H-unter/CC3501-Assignment-2/README.md

# CC3501 Assignment 2

design and build an embedded system to produce a useful product.
