H-unter/CC3501-Assignment-2/report/main.tex

\documentclass[11pt]{article} 
\def\names{Hunter Kruger-Ilingworth (14198489)\\ 
Quentin Bouet (14198423) \\
Thomas Mehes (14259613) \\}
\def\doctitle{Assignment 2 \\ Dew Point Generator Controller and Sensor Data Logger}
\def\subjectcode{CC3501}
\input{header.sty}

%Choose which files are re-rendered (saves rendering time)
%\includeonly{}

\newcommand{\insertimage}[3]{
\begin{figure}[h]
    \centering
     % Image filename
    \caption{#2} % Caption
    \label{#3} % Label
\end{figure}
}

\newcommand{\insertbigimage}[3]{
\begin{figure*}[h]
    \centering
     % Image filename
    \caption{#2} 
    \label{#3} 
\end{figure*}
}

\newcommand{\codeblock}[4]{
    \lstinputlisting[language=#1, caption={#2}, label=#3]{#4}
}

\newcommand{\E}[1]{
    \cdot 10^{#1}
}

\newcommand{\abs}[1]{
    \left\lvert #1 \right\rvert
}

\newcommand{\note}[1]{\textcolor{red}{#1}} %create a note for yourself

\definecolor{codegray}{gray}{0.9} % Light gray color
\newcommand{\code}[1]{\colorbox{codegray}{\texttt{\detokenize{#1}}}} % Command for inline code

\begin{document}
    % Create the title page
    \begin{titlepage}
        \maketitle
        \thispagestyle{empty} %suppresses page numbering on the title page
    \end{titlepage}

    % Table of Contents
    \thispagestyle{empty} % Suppresses page numbering on the contents page
    \onecolumn
    \tableofcontents
    \listoffigures
    \listoftables

    % Document - place new files as needed
    \clearpage
    \input{sec1_intro}
    \input{sec2_overview}
    \input{sec2.1_hardware_design}
    \input{sec2.2_comm_protocols}
    \input{sec2.3_user_interface}
    \input{sec3.1_challenges}
    \input{sec3.2_discussion}
    \input{sec3.3_recommendations}
    \input{sec4_conclusion}
    \input{sec5_appendix}

    \bibliographystyle{IEEEtranN} 
    \bibliography{references} 

\end{document}
