H-unter/CC3501-Assignment-2/report/figures/SDI-12 circuit.png

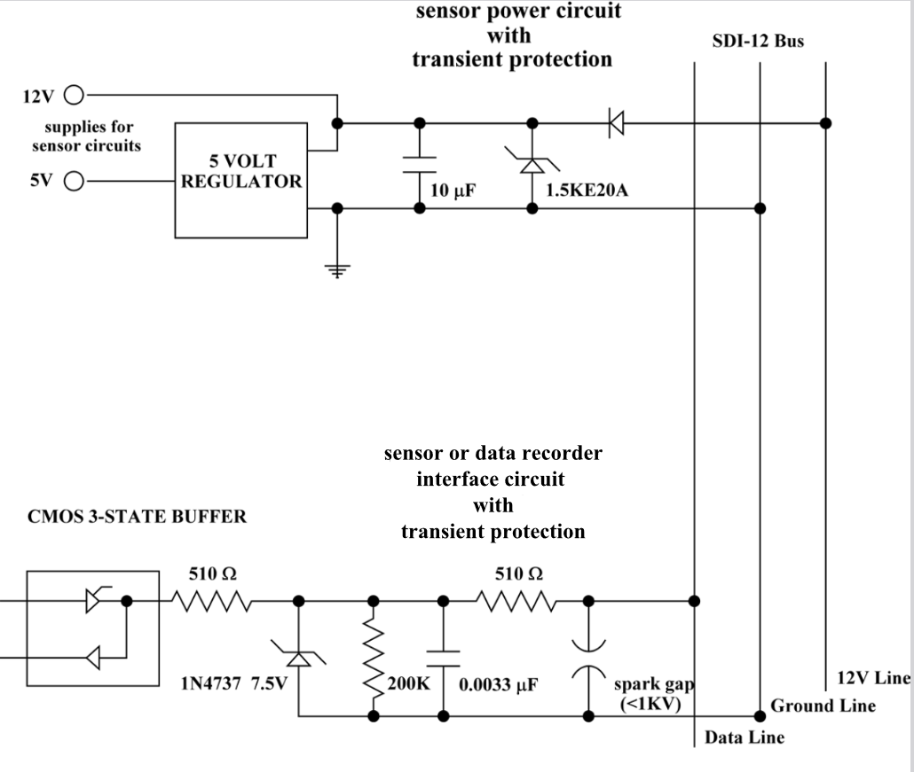
report/figures/SDI-12 circuit.png
