H-unter/CC3501-Assignment-2/report/figures/system_setup_2.jpg

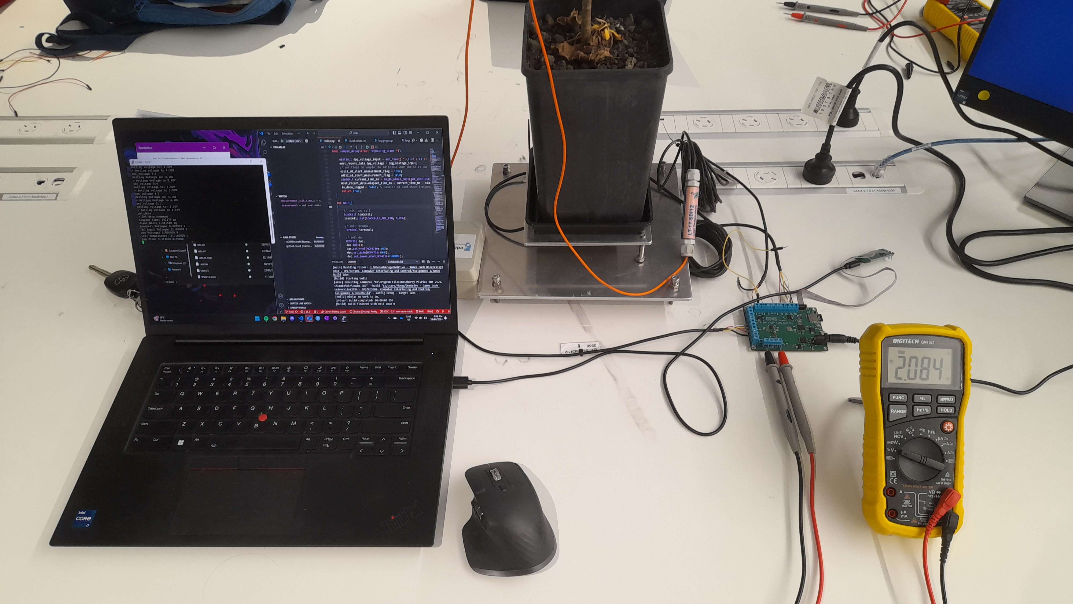
report/figures/system_setup_2.jpg
