H-unter/CC3501-Assignment-2/misc/loadcell_tuning_round2/mass_to_voltage.xlsx

mass_kg | voltage_v
0 | 0.131821
0.475 | 0.305
0.53 | 0.327356
0.885 | 0.447
1.565 | 0.679
2.28 | 0.9
2.81 | 1.047
3.895 | 1.286
4.3675 | 1.396
