H-unter/CC3501-Assignment-2/misc/loadcell_tuning_round1/loadcell_linearity_test.xlsx

input_kg | output_v | gain
0 | 0.76 | 75
0.2 | 0.76
0.4 | 0.76
0.6 | 0.76
1.8 | 0.76
2 | 0.824
2.2 | 0.89
2.4 | 0.962
2.6 | 0.994
2.8 | 1.02
3 | 1.05
3.2 | 1.09
3.4 | 1.14
3.6 | 1.18
3.8 | 1.22
4 | 1.24
4.2 | 1.29
4.4 | 1.33
4.6 | 1.37
4.8 | 1.39
5 | 1.44
