H-unter/CC3501-Assignment-2/misc/adc_smoothing_test/smoothed_readings_plot.pdf

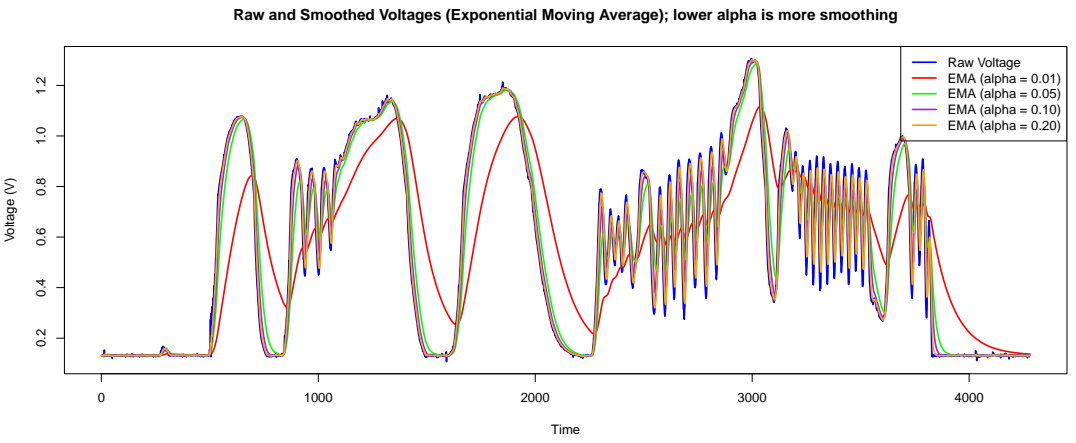
[picture p31: page 1]
Time; Voltage (V); Raw Voltage EMA (alpha = 0.01) EMA (alpha = 0.05) EMA (alpha = 0.10) EMA (alpha = 0.20)

Raw and Smoothed Voltages (Exponential Moving Average); lower alpha is more smoothing
