H-unter/CC3501-Assignment-2/misc/hardware_submission_files/Schematics.PDF

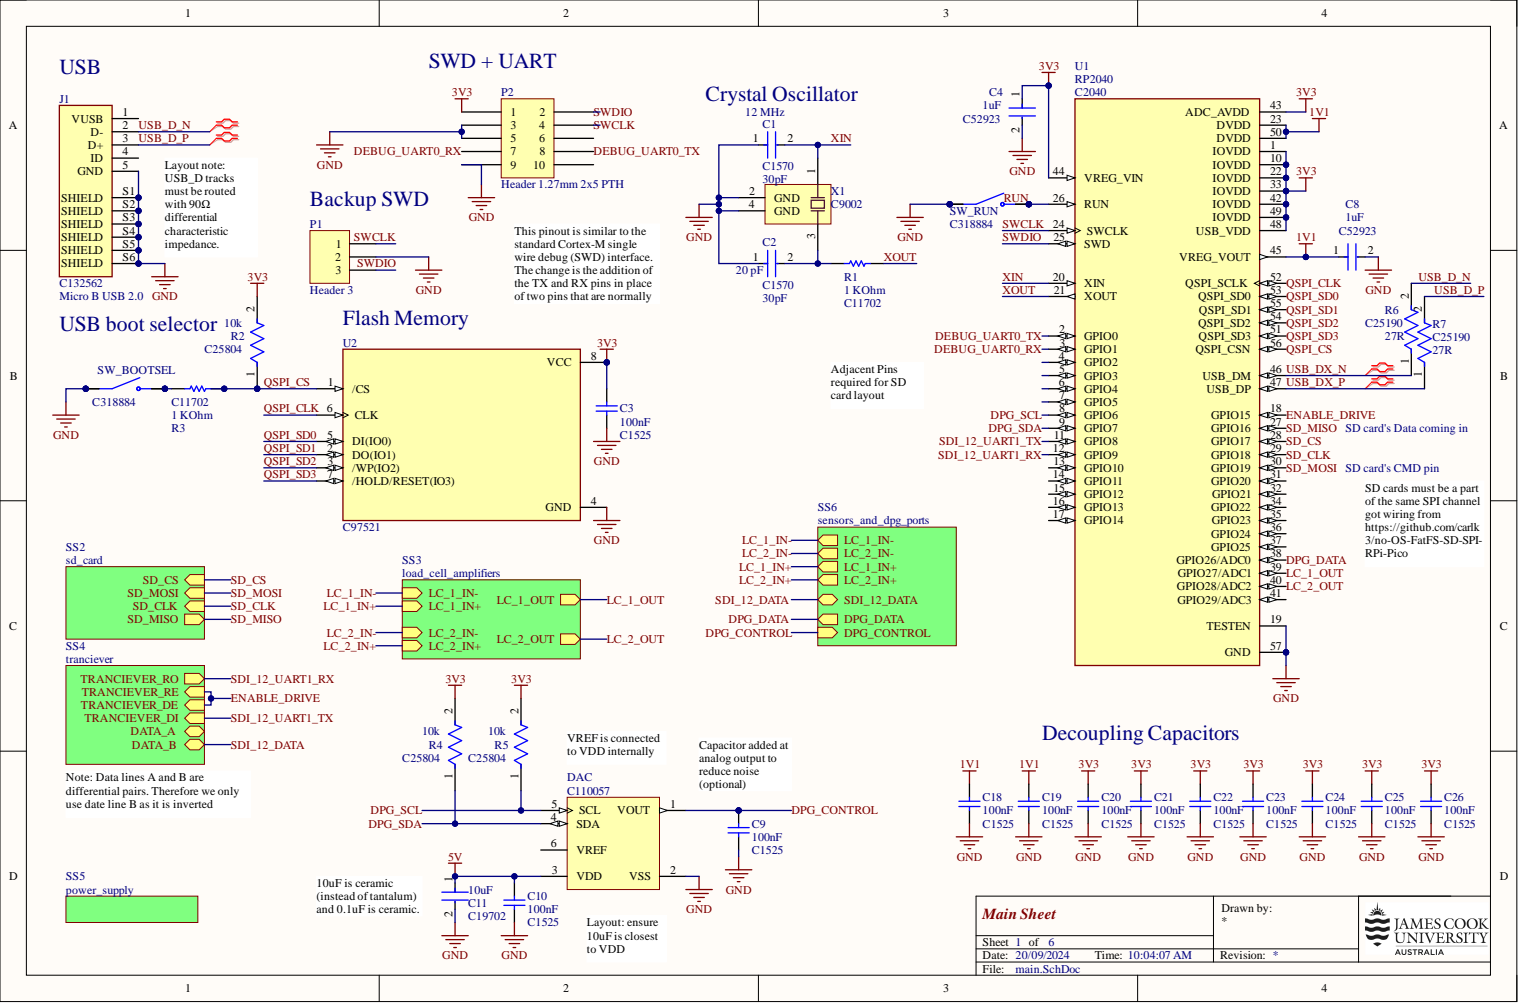
[picture p32: page 1]

This pinout is similar to the
standard Cortex-M single
wire debug (SWD) interface.
The change is the addition of
the TX and RX pins in place
of two pins that are normally

SD card's Data coming in

SD card's CMD pin
SD cards must be a part
of the same SPI channel
got wiring from
https://github.com/carlk
3/no-OS-FatFS-SD-SPI-
RPi-Pico

Note: Data lines A and B are
differential pairs. Therefore we only
use date line B as it is inverted

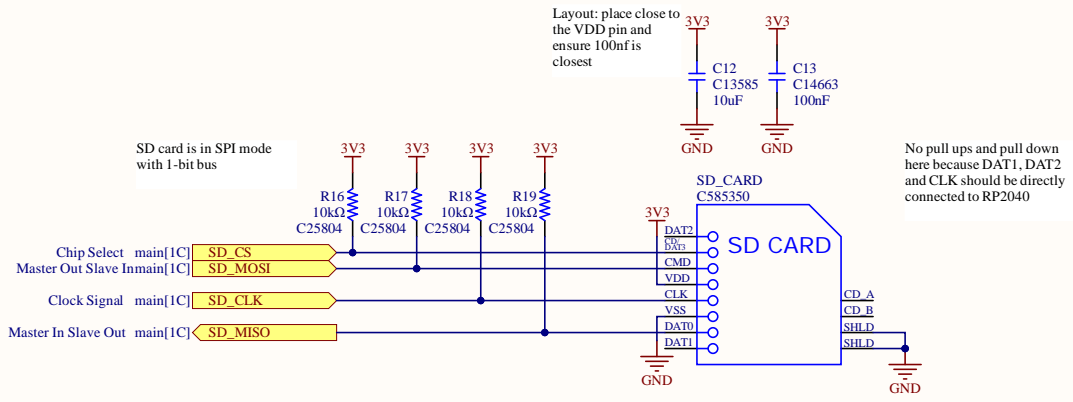
[picture p33: page 2]

Layout: place close to
the VDD pin and
ensure 100nf is
closest

SD card is in SPI mode
with 1-bit bus

No pull ups and pull down
here because DAT1, DAT2
and CLK should be directly
connected to RP2040

Chip Select
Master Out Slave In

Master In Slave Out

SD Card Reader Header

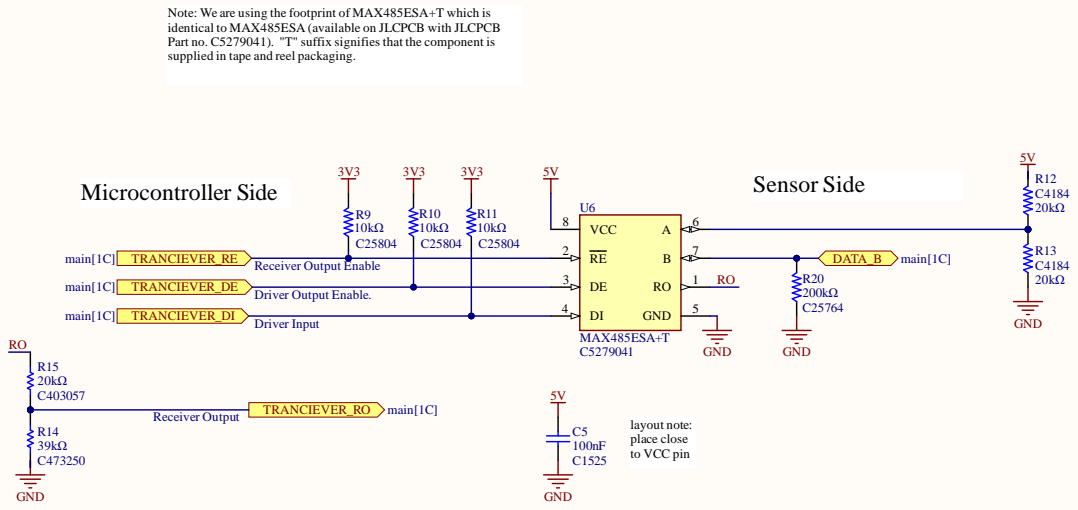
[picture p34: page 3]

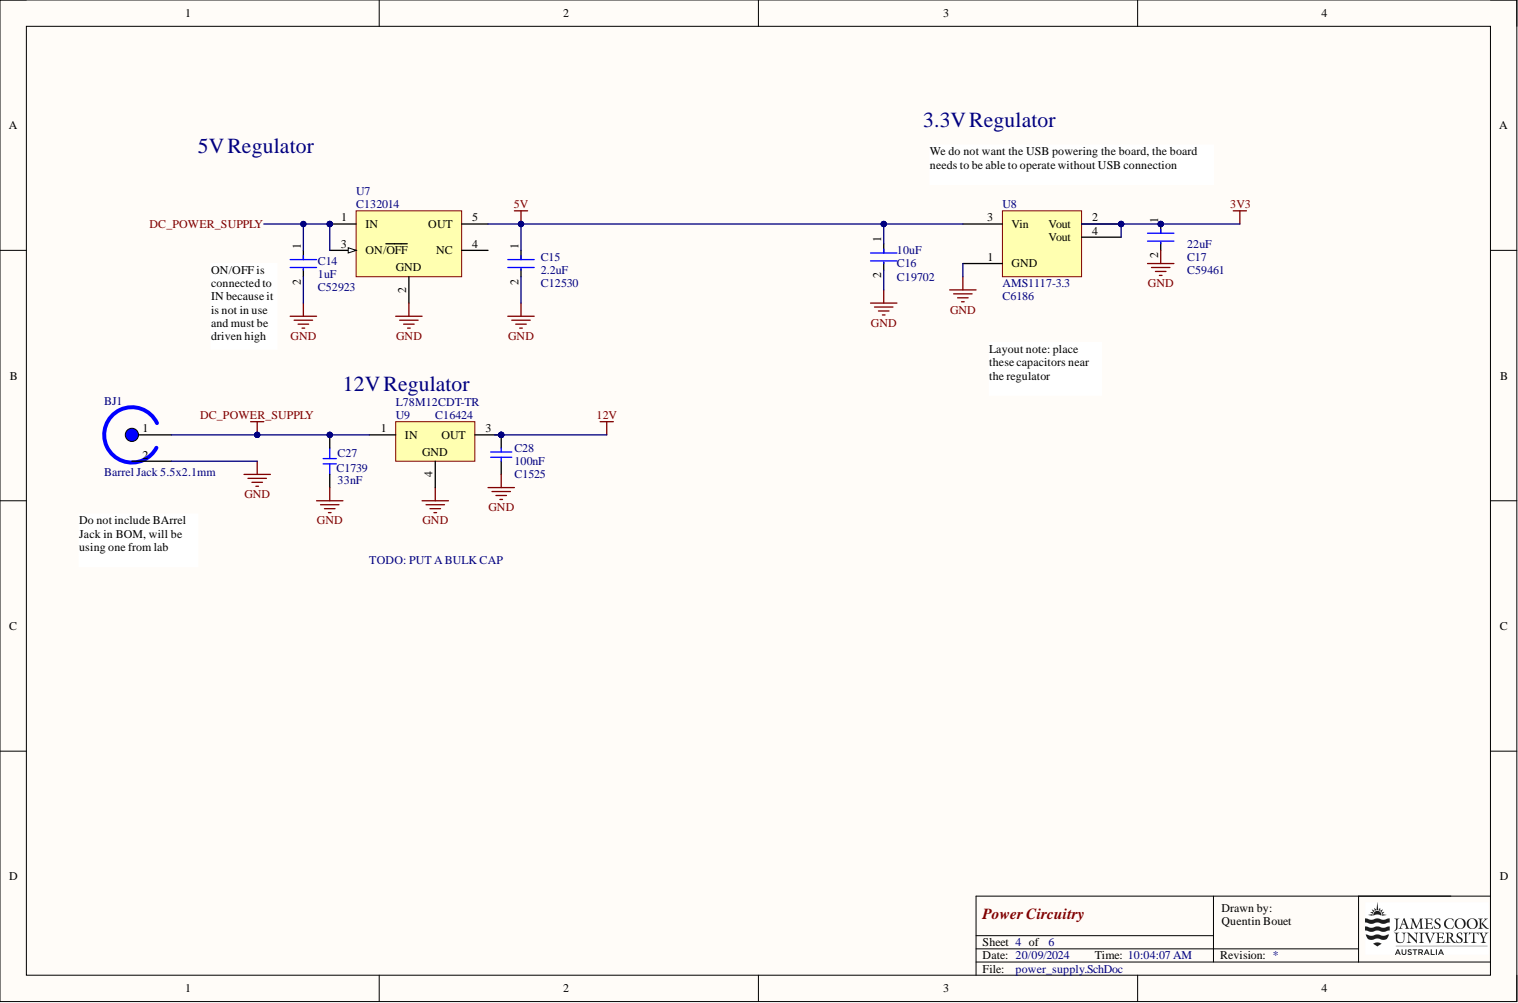
[picture p35: page 4]

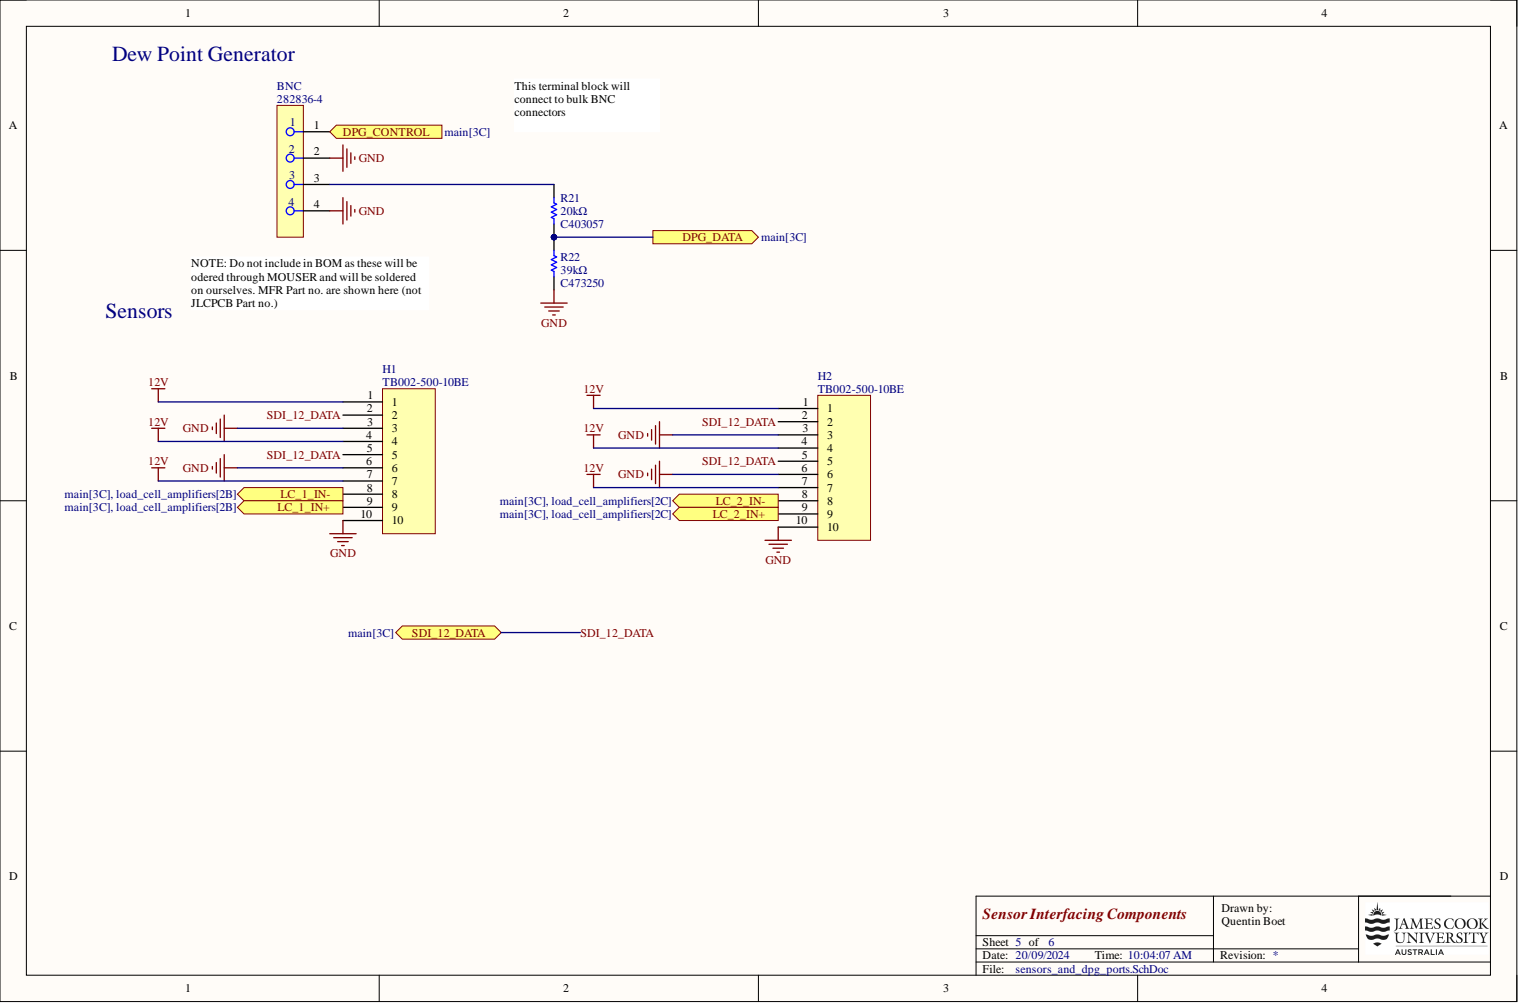
[picture p36: page 5]

This terminal block will
connect to bulk BNC
connectors

NOTE: Do not include in BOM as these will be
odered through MOUSER and will be soldered
on ourselves. MFR Part no. are shown here (not

JLCPCB Part no.) Sensors

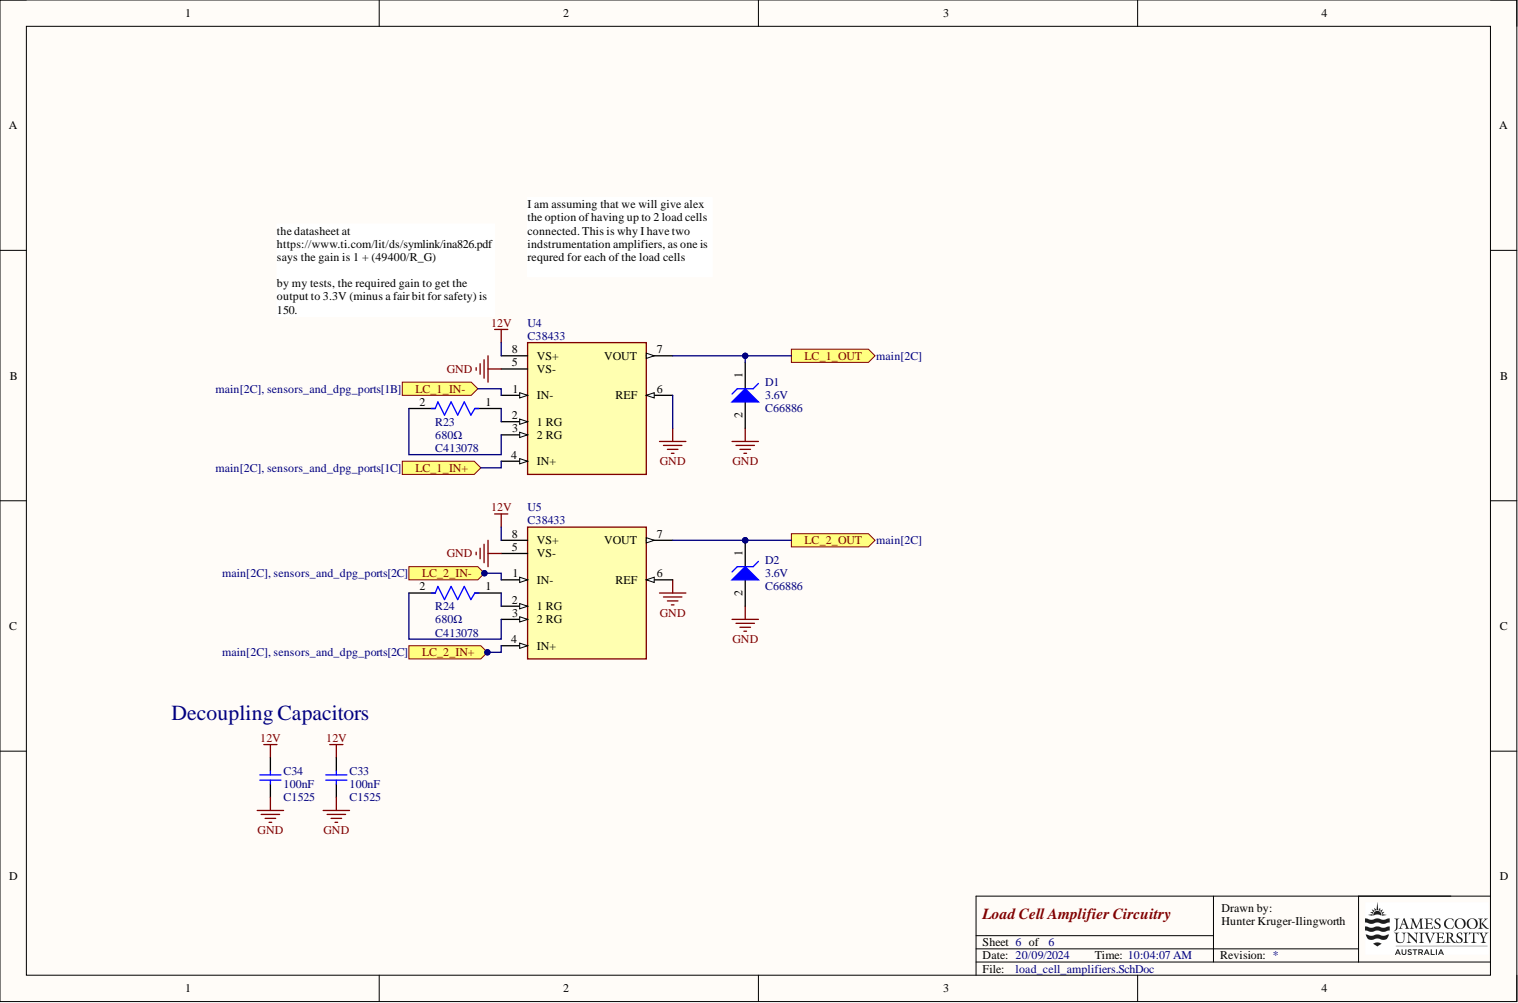
[picture p37: page 6]

I am assuming that we will give alex
the option of having up to 2 load cells
connected. This is why I have two
indstrumentation amplifiers, as one is
requred for each of the load cells

the datasheet at
https://www.ti.com/lit/ds/symlink/ina826.pdf
says the gain is 1 + (49400/R_G)

by my tests, the required gain to get the
output to 3.3V (minus a fair bit for safety) is

Load Cell Amplifier Circuitry
