H-unter/CC3501-Assignment-2/(list of files, drawings)

Other design files:
Altium files/Group 2 Assignment 2.PrjPcb
Altium files/load_cell_amplifiers.SchDoc
Altium files/main.SchDoc
Altium files/power_supply.SchDoc
Altium files/sd_card.SchDoc
Altium files/sensors_and_dpg_ports.SchDoc
Altium files/tranciever.SchDoc
