H-unter/CC3501-Assignment-2/code/src/board.h

// terminal parameter definitions
#define TERMINAL_UART_INSTANCE uart0 // UART instance for terminal communication
#define DEBUG_UART_RX_PIN 1
#define DEBUG_UART_TX_PIN 0

// sdi-12 parameter definitions
#define SDI12_UART_INSTANCE uart1 //
#define SDI12_UART_TX_PIN 8
#define SDI12_UART_RX_PIN 9
#define ENABLE_DRIVE_PIN 15 // for SDI12 data line drive enable TODO: rename for cleanliness
#define SDI12_BAUD_RATE 1200
#define SDI12_MAX_RESPONSE_TIME_MS 15             // max sensor response time for most commands (pg.41 of datasheet)
#define SDI12_MAX_TRANSMIT_TIME_MS 380            // max sensor transmitting time for most commands (pg.41 of datasheet)
#define SDI12_MAX_TRANSMIT_TIME_CONCURRENT_MS 810 // max sensor transmitting time for concurrent measurement (longer than normal) (pg.41 of datasheet)

// SPI and SD card related definitions
#define SD_SPI_INSTANCE spi0     // SPI instance for SD card communication
#define SD_SPI_MISO_PIN 16       // MISO (Master In Slave Out) GPIO pin: SD_MISO from schematic
#define SD_SPI_SS_PIN 17         // Slave Select (SS) GPIO pin: SD_CS from schematic
#define SD_SPI_SCK_PIN 18        // Clock (SCK) GPIO pin: SD_CLK from schematic
#define SD_SPI_MOSI_PIN 19       // MOSI (Master Out Slave In) GPIO pin: SD_MOSI from schematic
#define SD_SPI_BAUD_RATE 1000000 // Baud rate for SD card SPI

// loadcell definitions
#define ALPHA 0.00f          // no smoothing because its kinda bad
#define LOADCELL0_ADC_PIN 27 // ADC pin for load cell 0
#define LOADCELL1_ADC_PIN 28 // ADC pin for load cell 1

// DAC definitions
// Define the I2C parameters
#define DAC_I2C_INSTANCE i2c1
#define DAC_I2C_ADDRESS 0x60         // MCP4716 I2C address (Refer to page 44 for addressing details)
#define DAC_I2C_BAUD_RATE 100 * 1000 // 100kHz I2C (Standard mode, page 44)
// Define SDA and SCL pins for I2C1
#define DAC_SDA_PIN 6
#define DAC_SCL_PIN 7

// DPG Input voltage
#define DPG_ADC_PIN 26
