H-unter/CC3501-Assignment-2/(commit log)

2024-08-18 Remove submodule
    [data.csv]
2024-08-18 Add assignment files
    [data.csv]
2024-08-19 Insert SDI-12 circuit diagram
2024-08-20 Add SPI-12 datasheet reference in document
2024-08-29 Defining design of DAC circuit
    - find reference circuit
    - choose VREF connection to VDD (internal)
    - calculate resolution to ensure that it matches the requirements (0.01V)
2024-08-30 Add 5V voltage regulator
    -LP2980AIM5-5.0/NOPB was chosen
    -2 versions of the datasheet were checked if they agree with circuit design
    - 2.2uF cap was found (CL05A225MQ5NSNC)
2024-09-04 Add software prototype
    copy paste lab 7 from CC2511
2024-09-04 Update software prototype
2024-09-06 Fix bug in main.cpp
    [main.cpp]
2024-09-07 Add sensors to block diagram
2024-09-07 Replace SDI-12 circuit figure with protocol timing
2024-09-11 Add reading from sensor
2024-09-11 Fix data corruption issue
    [main.cpp]
2024-09-11 Implement dynamic sensor reading timing
2024-09-17 Fix baud rate issue
    [sdi12.cpp]
2024-09-17 Add no-OS-FatFS as submodule
    no-OS-FatFS is the project where ill be getting the SD card SPI code from: https://github.com/carlk3/no-OS-FatFS-SD-SPI-RPi-Pico
2024-09-17 Attempt to get starter code running
    Likely an issue in the definition of hw_config.c and the CMakeLists not being linked the way I expect it to
    [board.h, main.cpp]
2024-09-17 Remove unused files
    [data_format.csv]
2024-09-19 Add load cell model
    [data_format.csv, loadcell_linearity_test.xlsx]
2024-09-19 Upload BOM and picknplace files
    [BOM.csv, picknplace.csv]
2024-09-20 Add files to SUBMIT!!!!!
    [BOM.csv, picknplace.csv]
2024-09-22 Move hardware files to miscellaneous folder
    [BOM.csv, picknplace.csv]
2024-09-27 Create simple voltage reading program
2024-09-27 Attempt to get good mass model for loadcell
    [loadcell_linearity_test.xlsx, mass_to_voltage.xlsx]
2024-10-02 Snap small mass values to 0
    [loadcell.cpp]
2024-10-03 Change board parameters to suit pcb
2024-10-03 Update DAC driver
2024-10-04 Update DAC driver with documentation
2024-10-05 Attempt to write to DAC register through I2C
2024-10-10 Add I2C scan code and swap SDA and SCL pins
    [board.h, main.cpp]
2024-10-14 Implement simple character input over uart0 in main
2024-10-15 Clean up DAC driver and board.h
2024-10-15 Update main.cpp to interface with dac
    hardware issues means this code can't be properly tested
    [MCP4716.cpp, main.cpp]
2024-10-17 Implement dac user interfacing
    accurate as bro 🤙
2024-10-17 Add data sample struct
2024-10-18 Fix FIFO timing issue
    [main.cpp]
2024-10-20 Fix slow response time bug
    [sdi12.cpp]
2024-10-21 Implement multi-sdi12 sensor polling
    issue: very slow
    [main.cpp]
2024-10-22 Crop board_photo.jpg
2024-11-08 Create Getting Started with Pico on PC Condensed.pdf
2024-11-08 Add Altium files
    [Group 2 Assignment 2.PrjPcb, load_cell_amplifiers.SchDoc, main.SchDoc, power_supply.SchDoc, sd_card.SchDoc, sensors_and_dpg_ports.SchDoc, tranciever.SchDoc]
